Keroloshany12/file-submissions/CHITATSI Project Poster (1).png

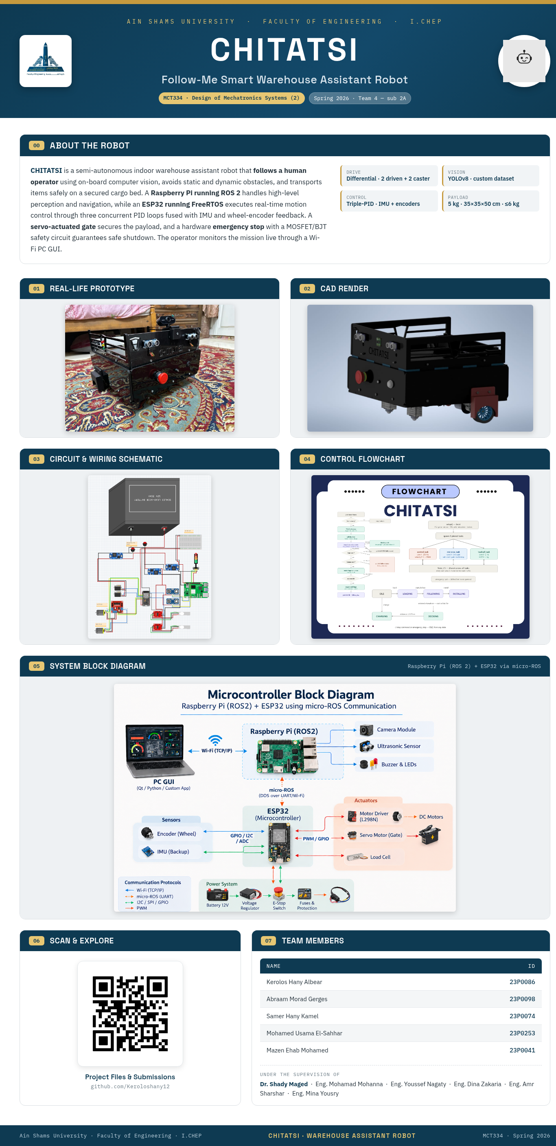
CHITATSI Project Poster (1).png
