Keroloshany12/file-submissions/report CHITATSI Final Submission.pdf

AIN SHAMS UNIVERSITY
I-Credit Hours Engineering Programs
(I. CHEP)

pg. 1

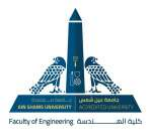
[picture p17: figure]

### AIN SHAMS UNIVERSITY

Faculty of Engineering
International Credit Hours Engineering Programs (I.CHEP)

MCT334 — Design of Mechatronics Systems (2) · Spring 2026

# CHITATSI

### Follow-Me Smart Warehouse Assistant Robot

FINAL SUBMISSION · PROJECT DOCUMENTATION

Team 4 — Sub 2A | ID
Kerolos Hany Albear | 23P0086
Abraam Morad Gerges | 23P0098
Samer Hany Kamel | 23P0074
Mohamed Usama El-Sahhar | 23P0253
Mazen Ehab Mohamed | 23P0041

Under the Supervision of
Dr. Shady Maged · Eng. Mohamad Mohanna · Eng. Youssef Nagaty · Eng. Dina Zakaria · Eng. Amr Sharshar · Eng. Mina Yousry

## Table of Contents

Table 2 Comparison between existing solutions and market needs | 6
Table 3— Price comparison between warehouse robotics solutions | 7
Table 4— ROI calculation. Payback ≈ 2.8 years, 36% annual return | 7
Table 5 Design constraint: the centre of gravity must remain within the wheelbase to prevent tipping | 8
Table 6 Functional Requirements | 8
Table 7 Subsystem Specifications | 8
Table 8 Safety Circuit | 9
Table 9 Performance Targets & Environment | 9
Table 10 KP08 Bearing Specifications | 12
Table 11 Tuned PID Gains | 21
Table 12 FreeRTOS Task Layout | 21

Figure 1— System block diagram: Raspberry Pi (ROS 2) + ESP32 over micro-ROS, with sensors, actuators, power
chain and communication protocols | 10
Figure 2— CHITATSI flowchart: vision pipeline (YOLO inference → logo/human match → follow_yaw), FreeRTOS task spawn, and the IDLE → LOADING → FOLLOWING → INSTALLING / CHARGING / DOCKING state machine. .... 10
Figure 3 Bearing Placement Configuration | 12
Figure 4 servo motor (MG995) | 13
Figure 5 Safety Circuit | 15
Figure 6 Battery selection | 16
Figure 7 — Full wiring layout: 12 V SLA battery, E-stop, buck converters, ESP32, L298N driver, motors, servos,
ultrasonic, IMUs, HX711 load cells, traffic-light indicator and Raspberry Pi | 17

## 01 Project Overview & Abstract

CHITATSI is a fully functional model of a semi-autonomous “Follow-Me” warehouse robot designed to enhance operational efficiency through intelligent human-following and real-time interaction within indoor warehouse environments. It demonstrates the integration of mechanical design, embedded systems and electronic control — covering sensor fusion, motion control, computer vision and autonomous navigation.

### 1.1 Project Objective

Design and develop a semi-autonomous indoor warehouse robot capable of:

- Following a human operator using vision tracking
- Avoiding static and dynamic obstacles
- Transporting warehouse items safely
- Securing items with a servo-actuated gate
- Operating using ROS 2 high-level and RTOS-based low-level control
- Communicating with a PC GUI over Wi-Fi

### 1.2 System Description

The robot is a compact mobile platform for indoor warehouse assistance, operating in semi-autonomous mode: the human operator initiates the mission, and the robot autonomously performs navigation and following. A two-tier control architecture splits responsibilities — a Raspberry Pi (ROS 2) handles vision, navigation and the high-level state machine, while an ESP32 (FreeRTOS) handles deterministic real-time motor control, sensor fusion and the gate mechanism, bridged through micro-ROS.

Key Specifications at a Glance

Max payload | Max speed | Tracking accuracy | Runtime
5 kg | 0.6 m/s | ≥ 90% | ≥ 45 min

## 02 Market Research

Follow-Me Warehouse Robot · Target: Mid-Size E-commerce Fulfilment Centres (Egypt & MENA)

### 2.1 Is There Demand?

There is clear, growing demand for assistive warehouse robotics in mid-size e-commerce fulfilment centres. Workers typically walk 8–15 km per shift during manual picking, causing fatigue, reduced efficiency and higher injury risk. As e-commerce grows across Egypt and MENA, fulfilment centres face rising order volumes, faster-delivery pressure, high labour turnover and seasonal scaling challenges. Large-scale automation is too expensive and complex for mid-size operations, creating demand for a cost-effective collaborative robot that assists workers without full infrastructure changes.

### 2.2 Who Will Buy?

Mid-size fulfilment centres with 20–100 pickers, manual or semi-manual systems, growing order volumes and limited automation budgets. Decision makers: Operations Manager, Fulfilment Centre Manager, Supply Chain Director and CFO — focused on productivity, cost reduction, ROI and operational efficiency.

### 2.3 Market Size

Egypt has hundreds of mid-size fulfilment centres on manual systems. If 100–200 warehouses adopt robotics over 5–7 years at 2–3 robots each, potential demand reaches 300–600 robots in Egypt alone, with the GCC expanding the total addressable market. The regional market is emerging and not yet saturated.

### 2.4 Competitors

Locus Robotics (Global) — leading AMR company for collaborative picking; enterprise-scale, Robotics-as-a-Service. MARSES Robotics (Local, Egypt) — regional integrator delivering project-based industrial automation, not specialised in follow-me collaborative picking.

Market Gap
Table 1 Comparison between existing solutions and market needs.
Factor | Locus | MARSES | Mid-Size | Gap
Target | Large enterprise | Industrial projects | Mid-size e-comm | Lack of focus
Cost | High | Project-dependent | Budget-sensitive | Need affordable
Complexity | Advanced fleets | Custom integration | Limited infra | Simple deploy
Automation | Full AMR fleet | Industrial robotics | Mostly manual | Need assistive
Integration | Advanced WMS | Project-based | Semi-manual | Plug-and-play

### 2.5 Pricing Comparison

Table 2— Price comparison between warehouse robotics solutions.

Solution | Model | Estimated Cost | Target
Locus Robotics | RaaS subscription | ~$1,000–1,500 / robot / month | Large enterprise
MARSES Robotics | Custom project | ~$30,000–60,000 / solution | Industrial
Proposed Follow-Me Robot | Direct purchase | ~$12,000–18,000 / robot | Mid-size e-comm

### 2.6 Return on Investment

Table 3— ROI calculation. Payback ≈ 2.8 years, 36% annual return.

Item | | Calculation | Value (EGP)
Worker monthly salary | — | 8,000
Annual worker cost | | 8,000 × 12 | 96,000
Productivity equivalent | — | 1.5 workers
Annual productivity value | | 96,000 × 1.5 | 144,000
Robot purchase cost | — | 400,000
Payback period | | 400,000 ÷ 144,000 | 2.78 years
ROI (annual) | | (144,000 ÷ 400,000) × 100 | 36%

### 2.7 Conclusion

A viable, financially feasible opportunity exists for a Follow-Me Warehouse Robot targeting mid-size e-commerce fulfilment centres in Egypt and MENA. Under a purchase model the system reaches a ~2.8-year payback with 36% annual return — within accepted industrial-automation thresholds.

## 03 Project Design Specification (PDS)

### 3.1 Physical & Dimensional

Table 4 Design constraint: the centre of gravity must remain within the wheelbase to prevent tipping.

Length × Width × Height | 35 × 35 × 50 cm
Chassis Material | E-Clarke board · PETG / PLA print · laser-cut acrylic
Estimated Total Weight | ≤ 6 kg
Maximum Payload | 5 kg
Operating Surface | Indoor flat warehouse floor

### 3.2 Functional Requirements

Table 5 Functional Requirements

ID | Requirement | Priority
FR1 | Follow a human operator using vision tracking | High
FR2 | Avoid static and dynamic obstacles | High
FR3 | Operate semi-autonomously | High
FR4 | Transport warehouse items safely | High
FR5 | Open and close a gate mechanism using a servo | High
FR6 | Implement a hardware emergency stop | Critical
FR7 | Communicate with a PC GUI via Wi-Fi | High
FR8 | Stop safely if the human target is lost | High

### 3.3 Subsystem Specifications

Table 6 Subsystem Specifications

Drive Configuration

Wheels | 2 driven + 2 caster
Drive type | Differential
Wheel diameter | 65 mm
Motors | DC geared + encoder
Max speed | 0.6 m/s
Control | PID velocity

Navigation

Type | Vision human-following
IMU / Encoders | Orientation / odometry
Obstacles | LiDAR / ultrasonic
Follow distance | 0.5–1.5 m
Reaction time | ≤ 200 ms

Control & Vision

Low-level | | ESP32 · FreeRTOS · PID · micro-ROS
High-level | | Raspberry Pi · ROS 2 · Nav/Vision/FSM
Vision | | Pi camera · ≥120 imgs · box+confidence
GUI | | Qt/Tkinter · Wi-Fi · battery, speed, camera

### 3.4 Safety Circuit

Table 7 Safety Circuit

Feature | | Implementation
Emergency Stop | | Latching push-button cutting actuator power
Reverse-Polarity | | MOSFET circuit
Overcurrent | Inline fuse
Undervoltage | | Battery Management System (BMS)
State Indicators | | Power LED + Fault LED
Cable Management | | Fully labelled wiring · breadboards not allowed

### 3.5 Performance Targets & Environment

Table 8 Performance Targets & Environment

Parameter | Target | Environment | Value
Max payload | 5 kg | Operating area | Indoor warehouse
Runtime | ≥ 45 min | Temperature | 20–35 °C
Tracking accuracy | ≥ 90% | Lighting | Artificial indoor
Max position error | ≤ 5 cm
Obstacle detection | ≥ 1.5 m

## 04 System Architecture & Operation

CHITATSI uses a two-tier control architecture. A Raspberry Pi running ROS 2 handles vision, navigation and the high-level state machine; an ESP32 running FreeRTOS handles deterministic real-time motor control, sensor fusion and the gate. The two are bridged by micro-ROS (XRCE-DDS over serial), and a PC GUI connects over Wi-Fi.

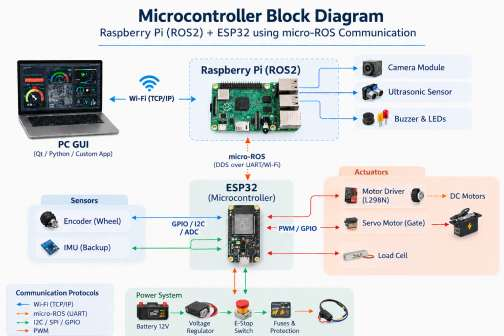
[picture p18: figure]

Figure 1— System block diagram: Raspberry Pi (ROS 2) + ESP32 over micro-ROS, with sensors, actuators, power chain and communication protocols.

### 4.1 Operational Flowchart & State Machine

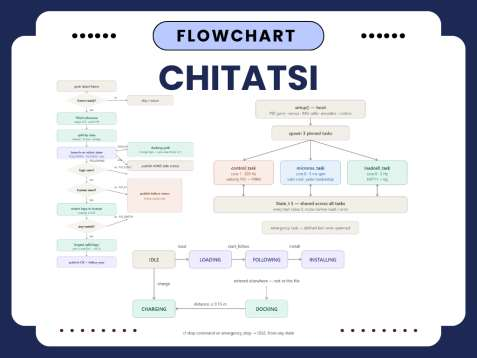
[picture p19: figure]

Figure 2— CHITATSI flowchart: vision pipeline (YOLO inference → logo/human match → follow_yaw), FreeRTOS task spawn, and the IDLE → LOADING → FOLLOWING → INSTALLING / CHARGING / DOCKING state machine.

## 05 Mechanical Design & Analysis

### 5.1 Drive & Shaft Configuration

A differential drive (2 driven + 2 caster wheels) was selected because it simplifies control, improves reliability and integrates efficiently with ROS 2 navigation. Each drive shaft (carbon steel AISI 1045, FoS ≥ 2 under combined bending & torsion) is supported by two deep-groove ball bearings in a locating + floating arrangement: the locating bearing constrains radial and axial motion, while the floating bearing carries radial load and allows axial displacement to absorb thermal expansion.

### 5.2 Full Dynamic Modelling

Robot Parameters

mass | 11 kg
Radius | 0.065 m
b | 0.33 m
Diemtere of shaft | 0.086 m

### 5.4 Bearing Selection & Load (KP08)

5.4.1 Purpose of Bearings
Bearings are mechanical components used to support rotating shafts and reduce friction between moving parts. In the drivetrain system of the Follow-Me Warehouse Robot, the shaft transmits torque from the DC motor to the drive wheel. Proper bearing support is required to maintain shaft alignment and ensure smooth wheel rotation. The bearings in the power screw system perform several essential functions:
- Support the rotating shaft
- Reduce friction during rotation
- Maintain alignment between the motor and wheel shaft
- Prevent excessive vibration or mechanical misalignment

Without proper bearing support, the screw shaft may experience excessive friction, instability.

5.4.2 Selected Bearing Type
For this design, a KP08 pillow block bearing is selected to support the drive shaft.
The KP08 bearing is a mounted bearing unit containing a deep groove ball bearing installed inside a cast housing. The housing allows the bearing to be mounted securely onto the robot chassis using two mounting bolts. Advantages of KP08 Bearing
- Easy mounting to the robot frame
- Integrated housing providing strong support
- Self-aligning capability
- Low friction during rotation
- Suitable for moderate loads and low rotational speeds

5.4.3 KP08 Bearing Specifications The specifications of the selected bearing
Table 9 KP08 Bearing Specifications
Parameter | Value
Bearing Model | KP08
Bearing Type | Pillow Block Bearing (A bearing mounted inside a housing that can be bolted to the frame)
Inner Diameter | 8 mm
Housing Material | Cast Iron
Mounting Type | Two-bolt mounting
Bearing Type | Deep Groove Ball Bearing (The internal ball bearing type that supports the rotating shaft)
Lubrication | Pre-lubricated (he bearing already contains grease for smooth operation)

The 8 mm inner diameter matches the diameter of the lead screw shaft used in the lifting mechanism.
5.4.4 Bearing Placement Configuration
To properly support the drivetrain shaft, two KP08 bearings are installed along the shaft between the DC motor and the wheel.
The system uses a locating and floating bearing configuration, which is commonly used in rotating shaft systems to prevent internal stresses.
Configuration used in this design:
- One locating bearing (fixed bearing)
- One floating bearing (non-locating bearing)
Position | Bearing Function
Bottom Bearing | Locating Bearing
Top Bearing | Floating Bearing
This arrangement ensures that the shaft position is fixed while still allowing slight axial movement caused by thermal expansion.

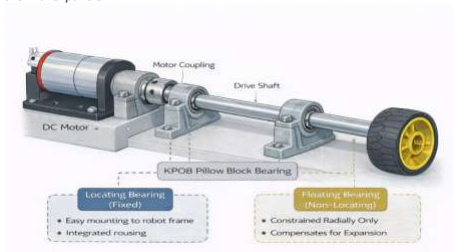
[picture p20: figure]

Figure 3 Bearing Placement Configuration

## 06 Extra Mechanism — Servo Gate

The robot includes a front-mounted, servo-actuated gate (1 DOF) that secures or releases transported items. The gate plate connects directly to the servo arm; a PWM signal from the ESP32 rotates the servo, swinging the plate from closed to open so an object can exit.

### 6.1 Motion Sequence

Robot reaches delivery location → ESP32 sends PWM signal → servo rotates 0° → 90° → gate plate moves → gate opens and object exits.

### 6.2Mechanism Description

The robot includes a servo-actuated gate mechanism used to control the release of objects from the robot compartment. The gate is directly connected to the servo arm, allowing rotational motion when the servo receives a PWM control signal from the microcontroller. When the servo rotates, the gate plate moves from a closed position to an open position, enabling the object to exit.

### 6.3 Mechanism Motion

Operation sequence:
1. Robot reaches delivery location
2. Microcontroller sends PWM signal
3. Servo rotates 90°
4. Servo arm moves the gate plate
5. Gate opens and object exits

### 6.4Torque Calculation

Assume object weight:
Object mass = 0.5 kg
F = m × g
F = 0.5 × 9.81 = 4.9N

Gate length (distance from servo center to object): L = 5cm = 0.05m

Torque:
T = F × L
T = 4.9 × 0.05
T = 0.245Nm
Parameter | Value
Motion type | Rotational
Rotation angle | 0° – 90°
Control signal | PWM
Controller | ESP32

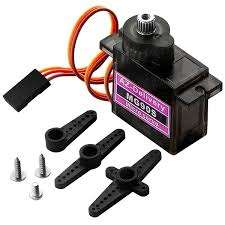
[picture p21: figure]

Figure 4 servo motor (MG995)

### 6.5 Servo Capability

SG90 Servo
Torque:
2.5kg ⋅ cm = 0.245Nm

Better servo option:
Parameter | Value
Required Torque | 0.245 Nm
Servo Torque | 1.0 Nm
Safety Factor | ≈ 4

### 6.6 Stability Consideration

Because the mechanism is small, explain that it does not affect the robot balance.
Example:
The gate mechanism has a low mass and is mounted close to the robot body. Therefore, it does not significantly affect the robot’s center of gravity or stability.

### 6.7 Mechanism Summary Table

Parameter | Value
Mechanism | Servo Gate
Actuator | Servo Motor
Gate Motion | Rotational
Rotation Angle | 0° – 90°
Control Method | PWM
Required Torque | 0.245 Nm
Servo Torque | 1.0 Nm

## 07 Electrical System & Safety

### 7.1 Power Architecture

The electrical system is organised into galvanically-referenced rails sharing a common ground star-point near the main battery: an 11.1 V (3S LiPo) main rail feeds the motor driver directly, and a 5 V buck-converter logic rail feeds the Raspberry Pi, ESP32 VIN, sensors and servo.

### 7.2 Functional Safety Circuit (MOSFET + BJT)

A P-channel MOSFET sits between the battery positive terminal and power distribution. To conduct, its gate must be pulled below source by V_GS(th) — done by an NPN BJT acting as a low-side switch. When the BJT saturates it pulls the gate to ground through a gate resistor, turning the MOSFET fully on; when off, a pull-up holds the gate at source (V_GS ≈ 0) and the MOSFET blocks. The E-stop line drives this stage, cutting motor power independently of firmware while keeping the ESP32 safe.

Gate V | Q1 (BJT) | MOSFET | Drain V | Current | Condition
High (12 V) | OFF | ON | ~0 V | ~15 A | Short circuit
Low (0 V) | ON | OFF | ~12 V | 0 A | Open circuit

Simulated in LTspice (IRFZ44N MOSFET, BC547 BJT, 0.8 Ω load → I = 12/0.8 = 15 A); schematic and PCB designed in Altium.

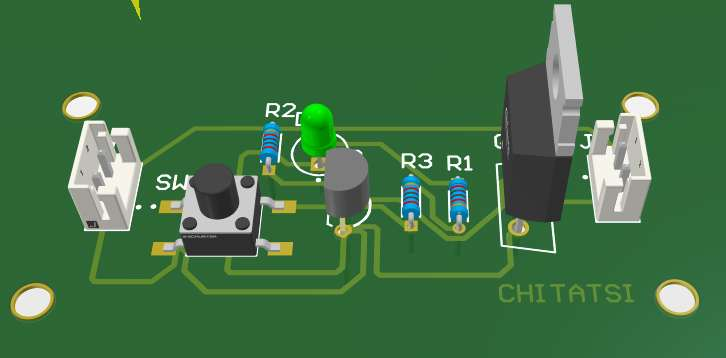
[picture p22: figure]

Figure 5 Safety Circuit

### 7.3 Current Budget & Battery Check

5 V Rail Component | Qty | Total A
Raspberry Pi 5 | 1 | 5.0
USB Webcam | 1 | 0.5
ESP32 | 1 | 0.25
Ultrasonic | 2 | 0.06
Servo (peak) | 2 | 2.0
HX711 | 2 | 0.05
Total → design for | | 7.86 → 8 A
Battery Peak Current Source | Current
Motors (stall, 2 × 5 A) | 10 A
Logic (8 A·5 V → 11.1 V) | 4 A
Total peak | 14 A
+30% safety margin | ≈ 18 A
BMS rating (available) | 20 A
Required 18 A < Available 20 A — battery capability confirmed.

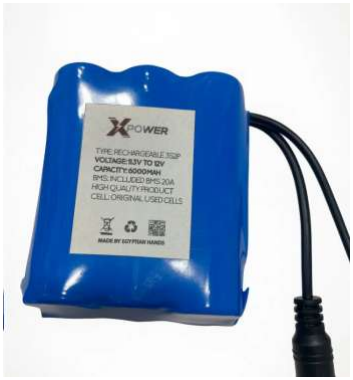
[picture p23: figure]

Figure 6 Battery selection

### 7.4 Wiring & Integration

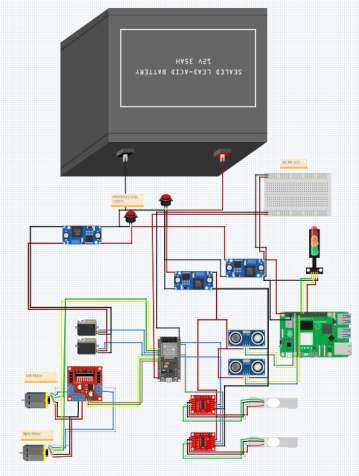
[picture p24: figure]

Figure 7 — Full wiring layout: 12 V SLA battery, E-stop, buck converters, ESP32, L298N driver, motors, servos, ultrasonic, IMUs, HX711 load cells, traffic-light indicator and Raspberry Pi.

## 08 Vision Module

The vision module detects and classifies the objects relevant to the robot's mission. Developed end-to-end: a custom dataset was collected and annotated in-house, a detection model was trained (not used off-the-shelf), and the model was wrapped in a ROS 2 node that publishes bounding boxes and per-detection confidence scores. The node runs on the Raspberry Pi from a live USB camera at a stable frame rate.

### 8.1 Overview

The vision module is responsible for detecting and classifying objects relevant to the robot's mission. It was developed end-to-end: a custom dataset was collected and annotated in-house, a detection model was trained (not merely used off-the-shelf), and the resulting model was wrapped in a ROS 2 node that publishes both bounding boxes and per-detection confidence scores on a dedicated topic. The node runs on the Raspberry Pi and consumes live frames from a USB camera at a stable frame rate.

### 8.2 Custom Dataset

A custom dataset was built from scratch rather than downloaded from public repositories. This ensures that the training distribution matches the actual deployment environment (indoor lighting, our specific target objects, camera lens characteristics, and typical viewing angles from the robot's perspective).

Dataset Composition
- Total images collected: 400 (exceeds the 100-image minimum).
- Capture conditions: varied lighting (natural, fluorescent, mixed), varied backgrounds, multiple distances (0.3 m – 2.5 m), and multiple viewing angles (0°, 45°, 90°).
- Image resolution: 640 × 480 native, resized to 416 × 416 during training.

### 8.3 Model Training

Transfer learning from YOLOv8n weights: the pre-trained backbone serves only as a feature extractor, and the detection head was retrained on our custom classes — making the model genuinely task-specific rather than a pre-trained black box.

### 8.4 ROS 2 Vision Node & Verification

The vision node subscribes to the camera stream, runs inference, and publishes a custom message (Detection2DArray) on the topic /vision/detections. Each detection includes the class ID, bounding box, and confidence score. A visual overlay is also published on /vision/image_annotated for debugging via rqt_image_view.

Verification
- ros2 topic echo /vision/detections confirms live messages with non-zero scores.
- ros2 topic hz /vision/detections shows ~8 Hz, matching the Pi 5 inference rate.
- Annotated image stream is viewable in rqt_image_view for qualitative validation.

## 09 Integrated Manufactured Mechanical System

### 9.1 Overview

The mechanical system was fabricated from the submitted CAD design and integrates the chassis, drive train, sensor mounts, electrical enclosure, battery bay, and an extra task-specific mechanism. Every component is mechanically fastened (screws, standoffs, or captive nuts); no adhesive-only joints carry structural load. The build was verified against the CAD files using a tape measure and calipers for critical dimensions (wheelbase, track width, sensor mount heights).

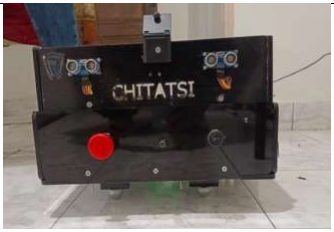
[picture p25: figure]
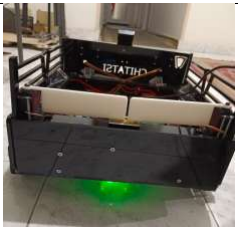
[picture p26: figure]
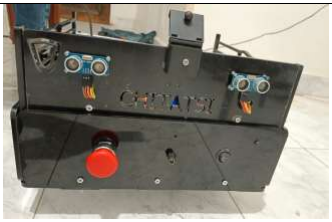
[picture p27: figure]
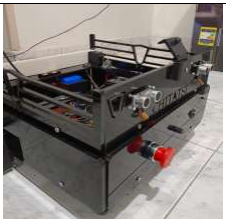
[picture p28: figure]

### 9.2 Assembly and Fixation of Components

- Chassis plates joined with M3 × 8 mm screws and brass standoffs, providing rigid, tool-accessible joints.
- Motors mounted using laser-cut brackets with four M3 fasteners per motor; no play detected under full-throttle reversal tests.
- Wheels secured with set screws onto D-shaft motor outputs

### 9.3 Extra Mechanism Integration

The extra mechanism is a servo-actuated gripper/manipulator assembled on the front of the chassis. It is mechanically mounted to the chassis front plate using four M3 screws and is electrically integrated with the main controller through a dedicated PWM channel with a shared ground reference.

Integration Details
- Mechanical: bolted to chassis front plate; tolerance fit checked against CAD.
- Electrical: servo signal wired to ESP32 PWM pin via a logic-level-matched header; dedicated 6 V BEC supplies the servo to avoid brown-outs on the main 5 V rail.
- Software: a dedicated FreeRTOS task commands the mechanism, decoupled from the motion-control loop so mechanism actuation does not disturb PID timing.

### 9.4 Sensor, Electronic, and Battery Fixation

- IMU (MPU6050) mounted on a vibration-damped bracket cantered on the chassis rotation axis to reduce gyro noise from motor vibration.
- Wheel encoders screw-mounted directly on the motor shafts with alignment verified optically.
- Raspberry Pi and ESP32 mounted on standoffs above the battery bay with 10 mm clearance for airflow.
- LiPo battery retained by a Velcro strap plus a 3D-printed captive bracket — cannot shift under impact.
- Ultrasonic / LiDAR / camera mounts are printed parts bolted, not glued, to the chassis.

### 9.5 Chassis and Body Fixation

The chassis is a two-layer plate design separated by M3 brass standoffs. The lower plate carries motors and battery; the upper plate carries computing and sensors. All panels are fastened with machine screws into captive nuts for serviceability. The body has been drop-tested from 20 cm with no structural loosening.

### 9.6 E-Stop, State Indicators, and Electrical Sockets

- Emergency stop: a red 22 mm mushroom-head push-button is mounted on the upper rear of the chassis, clearly visible and reachable without disturbing other components. It cuts the motor driver supply via a latching relay.
- State indicators: two LEDs (green = moving, red = fault / e-stop) mounted on a front-facing indicator panel.

## 10 Motor Control & PID (FreeRTOS)

### 10.1 Control Architecture

Motion control runs on the ESP32 as a FreeRTOS application with three concurrent PID loops plus a serial command handler. The architecture is layered: the position loop commands wheel-speed references, the wheel-speed PIDs track them, and the yaw PID corrects heading for straight-line motion or rotation-in-place.

- Wheel-speed PIDs (200 Hz): per-wheel; speed ref + filtered encoder speed → u ∈ [−1, 1].
- Position PID (50 Hz): distance error → common speed ref with a linear brake zone near target.
- Yaw PID (in 200 Hz loop): differential correction (straight) or equal-and-opposite wheels (rotate).
- Complementary filter: fuses MPU6050 gyro Z with encoder heading every control tick.

### 10.2 Sensor Fusion (IMU + Encoders)

A complementary filter (α = 0.98) favours the gyro short-term (low noise, drift-prone) and the encoder-derived heading long-term (drift-free, slip-prone). At boot, 300 stationary gyro samples are averaged to remove bias; a 0.3 dps deadband suppresses residual jitter. ψ is wrapped to [−180°, +180°] each tick.

### 10.3 Tuned PID Gains

Table 10 Tuned PID Gains

Loop | Kp | Ki | Kd | Notes
Left wheel speed | 2.25 | 0.30 | 0.0 | D=0, encoder noise high
Right wheel speed | 2.00 | 0.30 | 0.0 | Lower Kp: more torque
Position | 2.40 | 0.00 | 1.30 | D-dominant soft brake
Yaw correction | 0.08 | 0.20 | 0.002 | Small: added on v_ref
All four controllers share one pid_step with conditional-integration anti-windup. PWM mapping zeroes commands below a deadband and remaps above it into [PWM_MIN, PWM_MAX] with a square-root shape for finer low-speed resolution.

### 10.4 FreeRTOS Task Layout

Table 11 FreeRTOS Task Layout

Task | Rate | Core | Prio | Responsibility
control | 200 Hz | 1 | 5 | Encoder read, IMU fusion, yaw + wheel PIDs, motor write
position | 50 Hz | 0 | 3 | Distance error → common speed ref, brake zone
serial | 50 Hz | 0 | 2 | Parse commands, update state & PID gains
telemetry | 10 Hz | 0 | 1 | Diagnostic printout of state & PID outputs
The control task is pinned to core 1 alone — away from Wi-Fi, Bluetooth and telemetry — keeping Δt tight in the 200 Hz loop, which the D-term and complementary filter depend on. Shared state lives in one State_t guarded by S_mutex so commands and loops cannot race.

### 10.5 Tuning Procedure & Performance

- 90° turn converges within 1° tolerance, no overshoot.
- “go 1.0” → < 1 cm distance error at rest.
- Static drift bounded over a 5-minute stationary test.
- Early-stop reset prevents integrator wind-up at rest.

## 11 micro-ROS Communication

A micro-ROS agent on the Raspberry Pi bridges the ESP32 into the ROS 2 graph. The ESP32 firmware uses the micro-ROS library (rclc / rclc_executor) over a serial transport, letting other ROS 2 nodes — including the vision node — publish goals to the ESP32 and receive its state.

Transport / Agent | Topics
USB serial · 921600 baud · XRCE-DDS | /robot/state (pub · 50 Hz)
micro_ros_agent on the Pi | /cmd_vel (sub · geometry_msgs/Twist)
The ESP32 publishes fused yaw, linear velocity and encoder-derived position on /robot/state at 50 Hz, and subscribes to /cmd_vel, updating v_ref and ω_ref for the control loops.

### 11.1 Transport and Agent

- Transport: USB serial between ESP32 and Raspberry Pi at 921600 baud.
- Agent: micro-ros-agent launched on the Pi with: ros2 run micro_ros_agent micro_ros_agent serial --dev /dev/ttyUSB0 -b 921600
- Middleware: XRCE-DDS.

### 11.2 Tested Publisher and Subscriber

Publisher: robot state
The ESP32 publishes a /robot/state message (custom or geometry_msgs/Pose2D) at 50 Hz containing the fused yaw, linear velocity, and encoder-derived position.

Subscriber: velocity goal
The ESP32 subscribes to /cmd_vel (geometry_msgs/Twist). Incoming messages update v_ref and omega_ref for the control loops.

Verification
- ros2 topic list shows both /robot/state and /cmd_vel after the agent connects.
- ros2 topic echo /robot/state displays live pose at ~50 Hz.
- ros2 topic pub /cmd_vel geometry_msgs/Twist '{linear: {x: 0.2}, angular: {z: 0.0}}' causes the robot to drive forward.

## 12 Integration & Manufacturing

The mechanical system was fabricated from the submitted CAD and integrates chassis, drivetrain, sensor mounts, electrical enclosure, battery bay and the extra mechanism. Every component is mechanically fastened — no adhesive-only joint carries structural load — and the build was verified against the CAD with tape measure and calipers on critical dimensions.

### 12.1 Assembly & Fixation

- Two-layer chassis joined by M3×8 mm screws + brass standoffs; rigid, tool-accessible.
- Motors on laser-cut brackets, 4× M3 each; no play under full-throttle reversal.
- Wheels set-screwed onto D-shaft motor outputs.
- IMU on a vibration-damped bracket centred on the rotation axis.
- Pi & ESP32 on standoffs above the battery bay, 10 mm airflow clearance.
- Battery retained by Velcro + 3D-printed captive bracket; cannot shift on impact.

### 12.2 Extra-Mechanism Integration

The servo gate bolts to the chassis front plate with four M3 screws (tolerance fit checked against CAD). The servo signal reaches an ESP32 PWM pin through a logic-level-matched header, and a dedicated 6 V BEC supplies the servo to avoid brown-outs on the 5 V rail. A dedicated FreeRTOS task commands it, decoupled from the motion loop so actuation never disturbs PID timing.

### 12.3 E-Stop & State Indicators

Emergency stop: a red 22 mm mushroom-head button on the upper rear, visible and reachable, cutting motor-driver supply via a latching relay. State indicators: two front-panel LEDs (green = moving, red = fault / e-stop). The body was drop-tested from 20 cm with no structural loosening, and critical dimensions match the CAD within manufacturing tolerance.

## 12 Conclusion

CHITATSI was completed end-to-end, with each subsystem independently validated before integration. The vision module is trained on a custom dataset and publishes detections with confidence scores over ROS 2. The mechanical assembly matches the CAD within tolerance and includes an integrated servo gate, emergency stop and state indicators. The electrical system provides a hardware-level safety chain independent of firmware. Motion control uses a cascaded PID stack under FreeRTOS, with orientation from a gyro–encoder complementary filter, and micro-ROS bridges the ESP32 firmware into the ROS 2 graph.

Beyond the technical build, the market research confirms a financially feasible opportunity: a ~2.8-year payback and 36% annual return position the Follow-Me Warehouse Robot as a realistic, cost-effective assistant for the underserved mid-size e-commerce fulfilment segment in Egypt and MENA.

CHITATSI Team 4 — Sub 2A · MCT334 Design of Mechatronics Systems (2) · Ain Shams University, Faculty of Engineering · Spring 2026
