Keroloshany12/file-submissions/(list of files, drawings)

Other design files:
wiring diagram design2.fzz
